fdmxfarhan/openmv-soccer/Documents/cam-v4-pinout_b4fbafcb-fd48-4a86-926d-85c75c845b77.webp

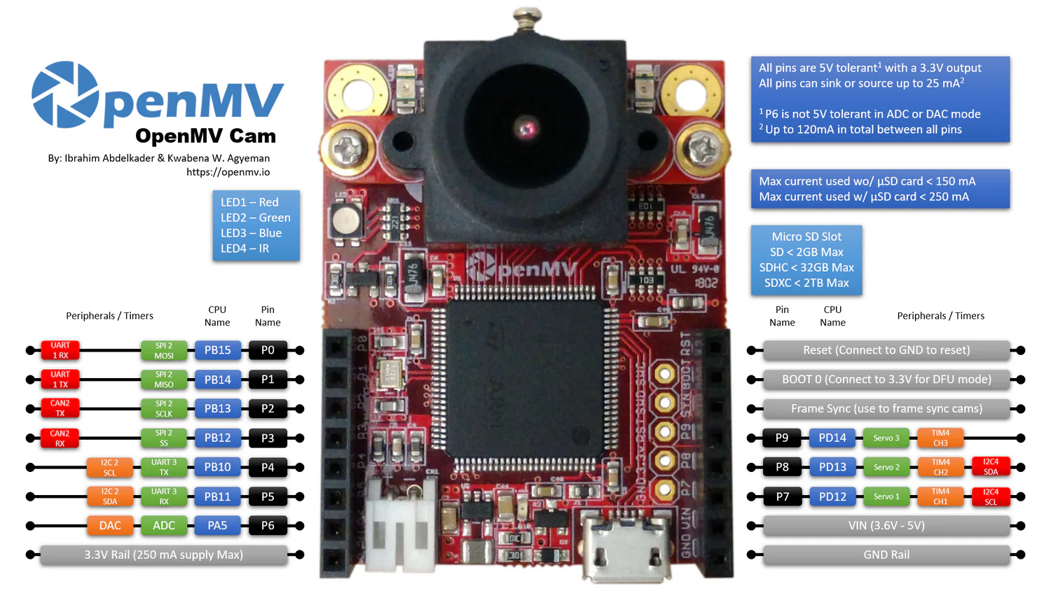
Documents/cam-v4-pinout_b4fbafcb-fd48-4a86-926d-85c75c845b77.webp
