fdmxfarhan/openmv-soccer/Documents/mt9m114-front.png

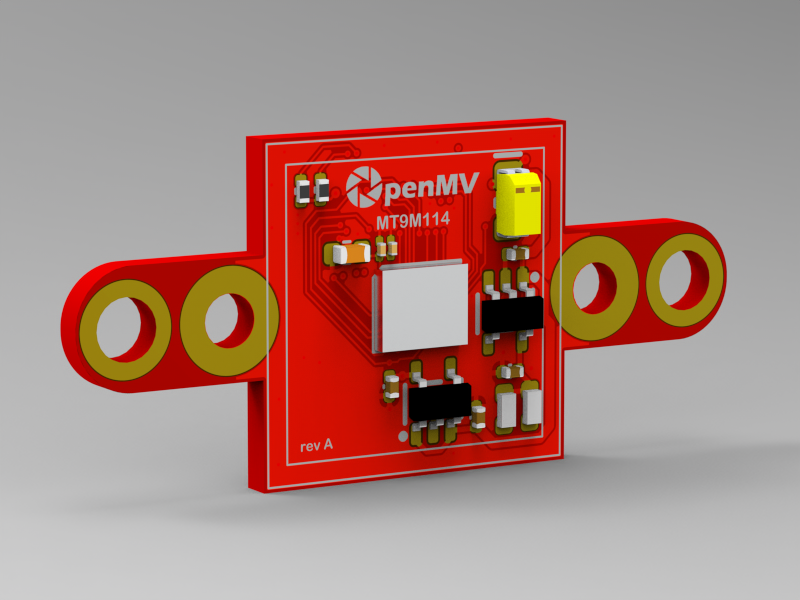
Documents/mt9m114-front.png
