fdmxfarhan/openmv-soccer/PCB Designs/trash/openmv2025.html

Altium customize

# Board Information Report

Date: | | 1/14/2025
Time: | | 6:33:35 PM
Elapsed Time: | | 00:00:01
Filename: | | C:\Users\Farhan\Documents\GitHub\openmv-soccer\PCB Designs\openmv2025.PcbDoc
Units: | | mmmils

## Contents

Contents

Board Specification

General

Routing

Routing Information

Layer Information

Layer Information

Drill Pairs

Copper Area

Copper Area

Board Holes

Non-Plated Hole Size

Plated Hole Size

Board Slots

Non-Plated Slot Size

Plated Slot Size

Board Square Holes

Non-Plated Square Hole Size

Plated Square Hole Size

Other

Top Layer Annular Ring Size

Mid Layer Annular Ring Size

Bottom Layer Annular Ring Size

Pad Solder Mask

Pad Paste Mask

Pad Pwr/Gnd Expansion

Pad Relief Conductor Width

Pad Relief Air Gap

Pad Relief Entries

Via Solder Mask

Via Pwr/Gnd Expansion

Track Width

Arc Line Width

Arc Radius

Arc Degrees

Text Height

Text Width

Net Track Width

Net Via Size

## Board Specification

General
Board Size | 130mm x 110.339mm
Components on board | 109

Back to top

## Routing

Routing Information
Routing completion | 100.00%
Connections | 206
Connections routed | 206
Connections remaining | 0

Back to top

## Layer Information

Layer | Arcs | Pads | Vias | Tracks | Texts | Fills | Regions | ComponentBodies
Top Layer | 2 | 194 | 0 | 715 | 0 | 1 | 0 | 0
Bottom Layer | 10 | 78 | 0 | 429 | 1 | 1 | 0 | 0
Mechanical 1 | 3 | 0 | 0 | 16 | 0 | 0 | 0 | 89
Mechanical 2 | 0 | 0 | 0 | 3 | 0 | 0 | 0 | 0
Mechanical 4 | 0 | 0 | 0 | 0 | 0 | 0 | 0 | 0
Mechanical 13 | 5 | 0 | 0 | 260 | 0 | 3 | 2 | 16
Mechanical 15 | 0 | 8 | 0 | 400 | 0 | 0 | 0 | 0
Multi-Layer | 0 | 155 | 124 | 0 | 0 | 0 | 1 | 0
Top Paste | 0 | 0 | 0 | 0 | 0 | 0 | 16 | 0
Top Overlay | 32 | 0 | 0 | 400 | 151 | 8 | 0 | 0
Top Solder | 0 | 0 | 0 | 0 | 0 | 0 | 0 | 0
Bottom Solder | 0 | 0 | 0 | 0 | 0 | 0 | 0 | 0
Bottom Overlay | 4 | 0 | 0 | 270 | 82 | 0 | 0 | 0
Bottom Paste | 0 | 0 | 0 | 0 | 0 | 0 | 0 | 0
Drill Guide | 0 | 0 | 0 | 0 | 0 | 0 | 0 | 0
Keep-Out Layer | 0 | 0 | 0 | 0 | 0 | 0 | 0 | 0
Drill Drawing | 0 | 0 | 0 | 0 | 0 | 0 | 0 | 0
Total | 56 | 435 | 124 | 2493 | 234 | 13 | 19 | 105

Back to top

Drill Pairs | Vias
Top Layer - Bottom Layer | 124
Total | 124

Back to top

## Copper Area

Layer | Sq.In. | Sq.MM. | Percent of layer
Top Layer | 4.437 | 2862.512 | 24%
Bottom Layer | 3.829 | 2470.58 | 21%
Total | 8.266 | 5333.092

Back to top

## Board Holes

Non-Plated Hole Size | Pads | Vias
Total | 0 | 0

Back to top

Plated Hole Size | Pads | Vias
0mm | 280 | 0
0.3mm | 0 | 124
0.7mm | 4 | 0
0.9mm | 27 | 0
1mm | 6 | 0
1mm | 69 | 0
1.016mm | 6 | 0
1.143mm | 30 | 0
1.3mm | 5 | 0
3.6mm | 5 | 0
3.8mm | 3 | 0
Total | 435 | 124

Back to top

## Board Slots

Non-Plated Slot Size / Length | Pads
Total | 0

Back to top

Plated Slot Size / Length | Pads
Total | 0

Back to top

## Board Square Holes

Non-Plated Square Hole Size | Pads
Total | 0

Back to top

Plated Square Hole Size | Pads
Total | 0

Back to top

## Other

Top Layer Annular Ring Size | Count
-0.127mm | 24
0.3mm | 124
0.5mm | 14
0.6mm | 29
1mm | 58
1.016mm | 6
1.2mm | 8
1.4mm | 5
1.8mm | 4
2.413mm | 6
3mm | 1
Total | 279

Back to top

Mid Layer Annular Ring Size | Count
-0.127mm | 24
0.3mm | 124
0.5mm | 14
0.6mm | 29
1mm | 58
1.016mm | 6
1.2mm | 8
1.4mm | 5
1.8mm | 4
2.413mm | 6
3mm | 1
Total | 279

Back to top

Bottom Layer Annular Ring Size | Count
-0.127mm | 24
0.3mm | 124
0.5mm | 14
0.6mm | 29
1mm | 58
1.016mm | 6
1.2mm | 8
1.4mm | 5
1.8mm | 4
2.413mm | 6
3mm | 1
Total | 279

Back to top

Pad Solder Mask | Count
-1.27mm | 8
0.1mm | 5
0.1016mm | 422
Total | 435

Back to top

Pad Paste Mask | Count
-7mm | 1
0mm | 434
Total | 435

Back to top

Pad Pwr/Gnd Expansion | Count
0.508mm | 435
Total | 435

Back to top

Pad Relief Conductor Width | Count
0.254mm | 435
Total | 435

Back to top

Pad Relief Air Gap | Count
0.254mm | 435
Total | 435

Back to top

Pad Relief Entries | Count
4 | 435
Total | 435

Back to top

Via Solder Mask | Count
0.1016mm | 124
Total | 124

Back to top

Via Pwr/Gnd Expansion | Count
0.508mm | 124
Total | 124

Back to top

Track Width | Count
0.05mm | 236
0.07mm | 364
0.1mm | 360
0.127mm | 115
0.15mm | 6
0.1524mm | 45
0.1778mm | 20
0.2mm | 179
0.25mm | 3
0.254mm | 18
0.3mm | 406
0.4mm | 44
0.7mm | 133
0.8mm | 137
1mm | 275
1.5mm | 111
2mm | 12
2.016mm | 3
2.5mm | 26
Total | 2493

Back to top

Arc Line Width | Count
0.1mm | 4
0.127mm | 1
0.1778mm | 4
0.2mm | 10
0.25mm | 11
0.254mm | 9
0.3mm | 1
0.6mm | 4
2.5mm | 12
Total | 56

Back to top

Arc Radius | Count
0.125mm | 11
0.127mm | 1
0.15mm | 2
0.3mm | 4
0.381mm | 2
0.5mm | 5
0.591mm | 4
0.8mm | 1
1.5mm | 1
2.5mm | 1
3.048mm | 2
4.9907mm | 6
5mm | 1
5.7765mm | 2
6.2mm | 1
55.1421mm | 1
56.6651mm | 2
61.9407mm | 2
62.0587mm | 5
62.7544mm | 1
65mm | 1
Total | 56

Back to top

Arc Degrees | Count
0 | 2
1 | 1
13 | 1
18 | 1
24 | 1
25 | 1
27 | 2
65 | 1
76 | 1
89 | 1
114 | 1
151 | 2
180 | 5
268 | 1
360 | 35
Total | 56

Back to top

Text Height | Count
0.8mm | 215
1mm | 11
1.5mm | 3
1.524mm | 5
Total | 234

Back to top

Text Width | Count
0.15mm | 1
0.1524mm | 1
0.18mm | 215
0.2mm | 10
0.254mm | 4
0.3mm | 3
Total | 234

Back to top

Net Track Width | Count
0.2mm | 171
Total | 171

Back to top

Net Via Size | Count
0.6mm | 171
Total | 171

Back to top
