fdmxfarhan/openmv-soccer/Documents/mt9m114-back.png

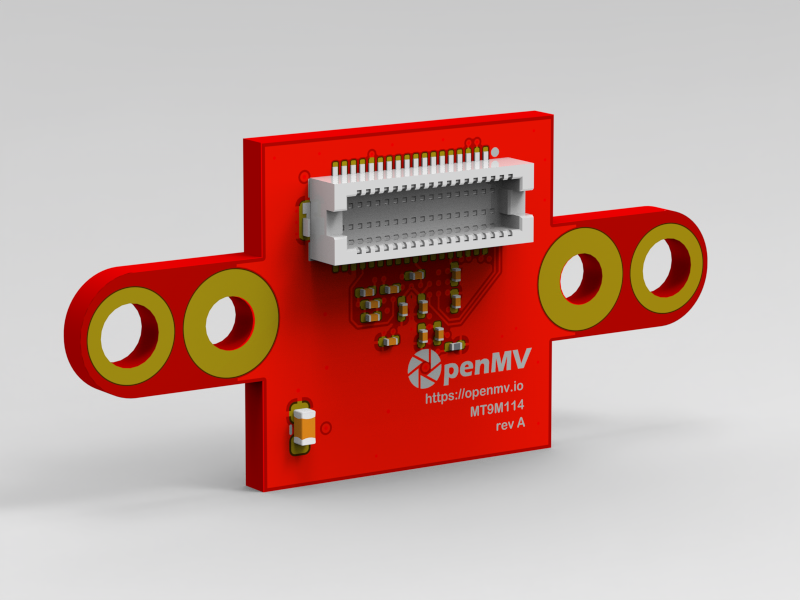
Documents/mt9m114-back.png
