fdmxfarhan/openmv-soccer/Documents/openmv-h7-alt.png

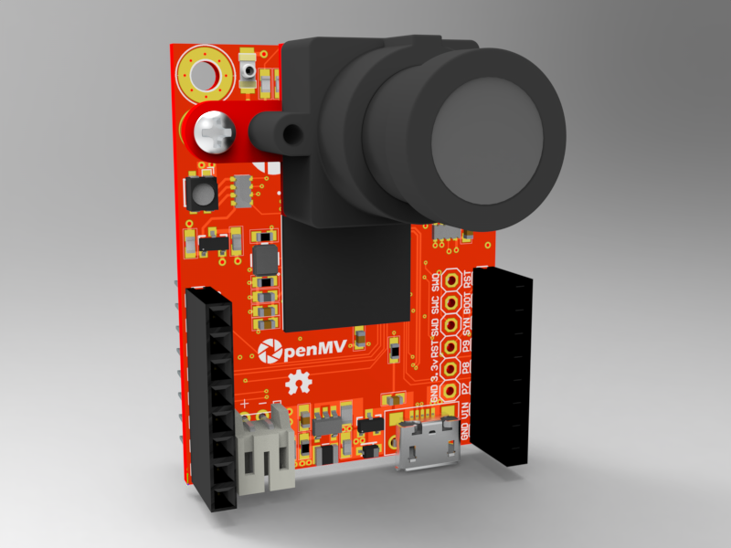
Documents/openmv-h7-alt.png
