fdmxfarhan/openmv-soccer/3D Design/01 Laptop holder/laptopholder.SLDPRT

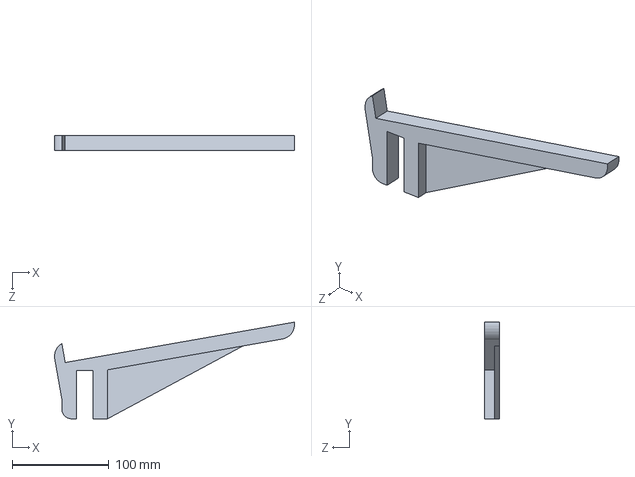
[picture p13: CAD file, 2025-03-11]
3D Design/01 Laptop holder/laptopholder.SLDPRT
247.6 x 99.8 x 15.0 mm
