fdmxfarhan/openmv-soccer/Documents/mt9m114.step

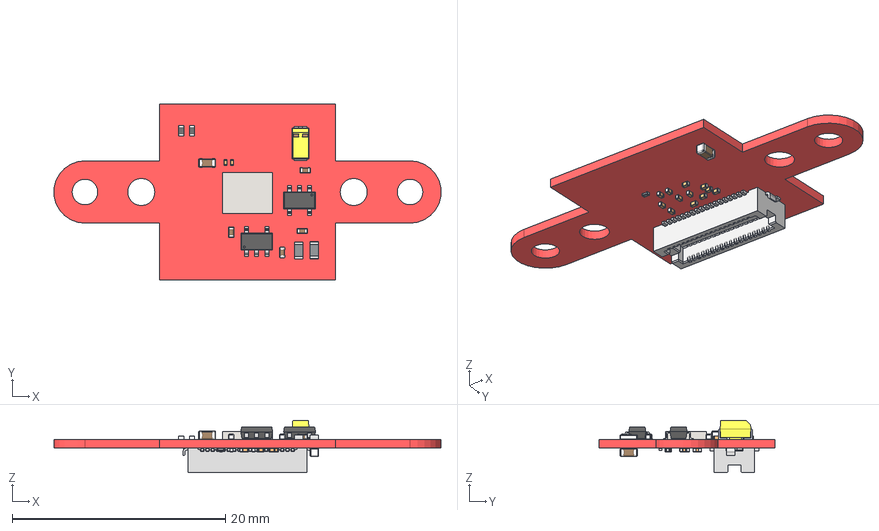
[picture p14: CAD file, 2025-02-07]
Documents/mt9m114.step
36.3 x 16.5 x 4.90 mm
SOT-23-5 x 2
CAP-0402 x 4
C0201_035 x 42
Extruded
R0201 x 4
DF1236
RES-0402 x 2
R0603 x 8
CAP-0603 x 2
Tantalum Capacitors 3216 47uf
