fdmxfarhan/openmv-soccer/3D Design/01 Laptop holder/laptopholder - Copy.SLDPRT

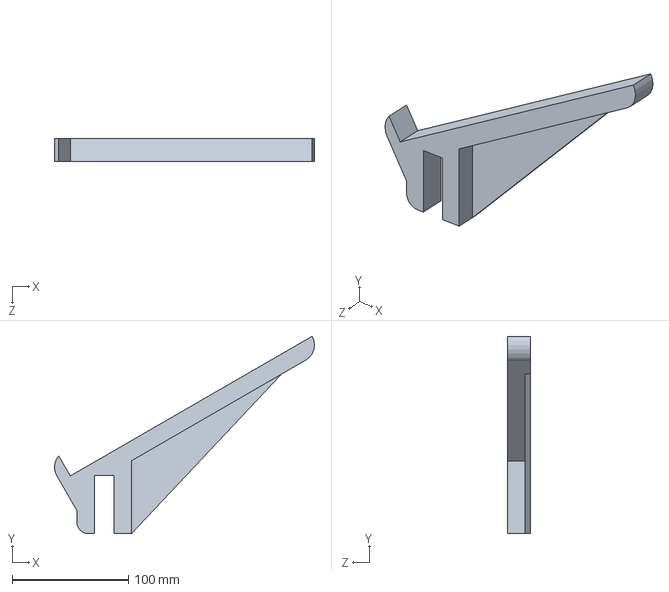
[picture p15: CAD file, 2025-02-15, an earlier design]
3D Design/01 Laptop holder/laptopholder - Copy.SLDPRT
223.4 x 169.7 x 20.0 mm
