fdmxfarhan/openmv-soccer/(list of files, cad)

Other CAD files:
PCB Designs/shavlon.DWG
3D Design/01 Laptop holder/laptopholder.STL
