fdmxfarhan/openmv-soccer/(list of files, drawings)

Other design files:
PCB Designs/Boost Converter/BoostConverter.PcbDoc
PCB Designs/openmv2025.SchDoc
